Harvey71/emdr/(threads)

Thread 1 (2021-05-01):

Einschraubmuffe

LennartHennigs, 2021-05-01:
Hey Thomas,
super Projekt - ich frage mal auf Deutsch, da mich die deutschen Maße interessieren: Was für eine Muffengröße hast du für das 3/8" Gewinde genommen? Ich muss ja grade im Baumarkt vorbestellen und es leider nicht vor Ort ausprobieren.

Ich baue auch grade eine EMDR Leiste und habe zum Glück dein Video gefunden.

(Und über die "Massage" Eier habe ich sehr lachen müssen. Großartige Idee.)

VG
Lennart

Harvey71, 2021-05-01:
Hallo Lennart,
ich habe bei Amazon einen 1/4 auf 3/8-Zoll Adapter bestellt (https://www.amazon.de/gp/product/B087JTZ6XJ).
Eigentlich ist der dazu da, in Kameras mit 3/8-Zoll-Gewinde eingedreht zu werden, um diese dann auf ein Stativ mit 1/4-Zoll-Gewinde zu montieren. Das Außengewinde ist ca. 7,3mm (Kernloch) auf 9,0mm (Außendurchmesser) und das habe ich als selbstschneidendes Gewinde missbraucht.
Dazu habe ich mit einem 8mm-Bohrer ein Senkloch mittig in die Holzleiste gebohrt. Da der Adapter auch noch einen Kragen von 9,5mm Duchmesser und 1,5mm Dicke hat, habe ich das Loch 1,5mm tief mit einem 10mm-Holzbohrer aufgeweitet. Es bedarf etwas Kraft, Gedult und einen passenden Schlitzschraubendreher, um den Adapter dann in dieses Senkloch einzudrehen. Dafür sitzt das dann aber auch fest und bietet ein sauberes 1/4-Zoll Innengewinde für das Stativ.
Am besten siehst du, wie ich das Gemacht habe im Video (https://www.youtube.com/watch?v=0NRr-7e_mLk) von 0:30 bis 1:15 min.
VG
Thomas

LennartHennigs, 2021-05-01:
Ah, super. Danke für die schnelle Antwort, das hilft mir weiter. Den Adapter habe ich auch. Dann werde ich noch mal in Ruhe Dein Video schauen.
Vielen Dank.

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

Closed 2021-06-24.

Thread 2 (2022-03-11):

Wiring of lightbar.

KaboomFox, 2022-03-11:
I followed https://github.com/PaulStoffregen/WS2812Serial and connected pin 17 to 24 on the teensy board and have the data pin of the LED Strip to going to 17 VIN teensy pin but I was looking at your video in the comments you said you hooked up the data out of the led strip to the DAC pin of teensy. What is the correct Wiring of the Lightbar to Teensy?

Harvey71, 2022-03-12:
Sorry, the comment in the video is incorrect. Connecting pin 24 and 17 is correct. But then you have to use the pin/connector "17 at Vin voltage" and connect it with Din on the light strip. "17 at Vin voltage" is exactly opposite to pin 26 and oddly has not a number on its own. I guess I mixed it up when ansering the comment in the video. I will clarify this in the video's comment as well as here. Thank you for the input.

Closed 2022-03-12.

Thread 3 (2022-06-29):

Issue with Lightbar connecting to Controller

Nigel214, 2022-06-29:
Howdy,

I've created the lightbar and have tested that it works by running some of the WS2812 examples in Arduino Sketch.

First question has to do with the lightbar.ino code.  Should the first line in the file do anything? I was getting an error so I remarked it out. This line:
@@ -0,0 +1, 55 @@

I've made sure the NUMLED is correct and the Port is correct (24).  I compile the lightbar software and upload to the Teensy LC and everything looks good, but when I run the controller software it is not seeing the lightbar USB.  My Teensy LC is running as Serial USB on Com8, and I am running the controller in Windows 10.  I've made sure I have the correct versions of PYUSB, PYGAME, and Thorpy.

Any help would be greatly appreciated!

Awesome project!

Harvey71, 2022-07-04:
Please ignore the @@ line - I do not know where it comes from and I will delete it in the next release.

Regarding USB: Have you installed libusb as well? For Windows you can download a DLL here: `https://github.com/libusb/libusb/releases/download/v1.0.26/libusb-1.0.26-binaries.7z`.

When connecting the lightbar, do you hear the Windows "connect sound" and does a "USB serial" device appear in the Windows Device Manager as "USB Serial" under "USB Devices"?

Can you run this simple python script and post the output?
```
import usb
for dev in usb.core.find(find_all=True):
    print(dev)
```

ooktown, 2023-04-17:
Greetings! I'm having a similar problem.

I have a Raspberry Pi 4B with 4GB, and I'm using a Teensy 3.2 to control the Lightbar. I have separately debugged the Teensy 3.2 to work with the LED strip (I installed some test programs to verify that I could control all 60 LEDs), and also verified that the Teensy responded properly on the serial monitor with "EMDR Lightbar" and passed the test() to light up two LEDs. (**_Side note_**: I used the level shifters you recommended, and I was able to drive all 60 LEDs simultaneously using an external power supply.)

I've also gotten the interface running and can hear the ping-pong sound when I use the audio option.

However, the lightbar is not recognized, and I can't use the visual bi-lateral stimulation. Before I try making the buzzer, I want to debug the lightbar.

Here is the output when I ran the python script in your last comment:

`DEVICE ID 1d6b:0003 on Bus 002 Address 001 =================
 bLength                :   0x12 (18 bytes)
 bDescriptorType        :    0x1 Device
 bcdUSB                 :  0x300 USB 3.0
 bDeviceClass           :    0x9 Hub
 bDeviceSubClass        :    0x0
 bDeviceProtocol        :    0x3
 bMaxPacketSize0        :    0x9 (9 bytes)
 idVendor               : 0x1d6b
 idProduct              : 0x0003
 bcdDevice              :  0x601 Device 6.01
 iManufacturer          :    0x3 Error Accessing String
 iProduct               :    0x2 Error Accessing String
 iSerialNumber          :    0x1 Error Accessing String
 bNumConfigurations     :    0x1
  CONFIGURATION 1: 0 mA ====================================
   bLength              :    0x9 (9 bytes)
   bDescriptorType      :    0x2 Configuration
   wTotalLength         :   0x1f (31 bytes)
   bNumInterfaces       :    0x1
   bConfigurationValue  :    0x1
   iConfiguration       :    0x0
   bmAttributes         :   0xe0 Self Powered, Remote Wakeup
   bMaxPower            :    0x0 (0 mA)
    INTERFACE 0: Hub =======================================
     bLength            :    0x9 (9 bytes)
     bDescriptorType    :    0x4 Interface
     bInterfaceNumber   :    0x0
     bAlternateSetting  :    0x0
     bNumEndpoints      :    0x1
     bInterfaceClass    :    0x9 Hub
     bInterfaceSubClass :    0x0
     bInterfaceProtocol :    0x0
     iInterface         :    0x0
      ENDPOINT 0x81: Interrupt IN ==========================
       bLength          :    0x7 (7 bytes)
       bDescriptorType  :    0x5 Endpoint
       bEndpointAddress :   0x81 IN
       bmAttributes     :    0x3 Interrupt
       wMaxPacketSize   :    0x4 (4 bytes)
       bInterval        :    0xc
DEVICE ID 16c0:0483 on Bus 001 Address 003 =================
 bLength                :   0x12 (18 bytes)
 bDescriptorType        :    0x1 Device
 bcdUSB                 :  0x110 USB 1.1
 bDeviceClass           :    0x2 Communications Device
 bDeviceSubClass        :    0x0
 bDeviceProtocol        :    0x0
 bMaxPacketSize0        :   0x40 (64 bytes)
 idVendor               : 0x16c0
 idProduct              : 0x0483
 bcdDevice              :  0x275 Device 2.75
 iManufacturer          :    0x1 Error Accessing String
 iProduct               :    0x2 Error Accessing String
 iSerialNumber          :    0x3 Error Accessing String
 bNumConfigurations     :    0x1
  CONFIGURATION 1: 100 mA ==================================
   bLength              :    0x9 (9 bytes)
   bDescriptorType      :    0x2 Configuration
   wTotalLength         :   0x43 (67 bytes)
   bNumInterfaces       :    0x2
   bConfigurationValue  :    0x1
   iConfiguration       :    0x0
   bmAttributes         :   0xc0 Self Powered
   bMaxPower            :   0x32 (100 mA)
    INTERFACE 0: CDC Communication =========================
     bLength            :    0x9 (9 bytes)
     bDescriptorType    :    0x4 Interface
     bInterfaceNumber   :    0x0
     bAlternateSetting  :    0x0
     bNumEndpoints      :    0x1
     bInterfaceClass    :    0x2 CDC Communication
     bInterfaceSubClass :    0x2
     bInterfaceProtocol :    0x1
     iInterface         :    0x0
      ENDPOINT 0x82: Interrupt IN ==========================
       bLength          :    0x7 (7 bytes)
       bDescriptorType  :    0x5 Endpoint
       bEndpointAddress :   0x82 IN
       bmAttributes     :    0x3 Interrupt
       wMaxPacketSize   :   0x10 (16 bytes)
       bInterval        :   0x40
    INTERFACE 1: CDC Data ==================================
     bLength            :    0x9 (9 bytes)
     bDescriptorType    :    0x4 Interface
     bInterfaceNumber   :    0x1
     bAlternateSetting  :    0x0
     bNumEndpoints      :    0x2
     bInterfaceClass    :    0xa CDC Data
     bInterfaceSubClass :    0x0
     bInterfaceProtocol :    0x0
     iInterface         :    0x0
      ENDPOINT 0x3: Bulk OUT ===============================
       bLength          :    0x7 (7 bytes)
       bDescriptorType  :    0x5 Endpoint
       bEndpointAddress :    0x3 OUT
       bmAttributes     :    0x2 Bulk
       wMaxPacketSize   :   0x40 (64 bytes)
       bInterval        :    0x0
      ENDPOINT 0x84: Bulk IN ===============================
       bLength          :    0x7 (7 bytes)
       bDescriptorType  :    0x5 Endpoint
       bEndpointAddress :   0x84 IN
       bmAttributes     :    0x2 Bulk
       wMaxPacketSize   :   0x40 (64 bytes)
       bInterval        :    0x0
DEVICE ID 2109:3431 on Bus 001 Address 002 =================
 bLength                :   0x12 (18 bytes)
 bDescriptorType        :    0x1 Device
 bcdUSB                 :  0x210 USB 2.1
 bDeviceClass           :    0x9 Hub
 bDeviceSubClass        :    0x0
 bDeviceProtocol        :    0x1
 bMaxPacketSize0        :   0x40 (64 bytes)
 idVendor               : 0x2109
 idProduct              : 0x3431
 bcdDevice              :  0x421 Device 4.21
 iManufacturer          :    0x0
 iProduct               :    0x1 Error Accessing String
 iSerialNumber          :    0x0
 bNumConfigurations     :    0x1
  CONFIGURATION 1: 100 mA ==================================
   bLength              :    0x9 (9 bytes)
   bDescriptorType      :    0x2 Configuration
   wTotalLength         :   0x19 (25 bytes)
   bNumInterfaces       :    0x1
   bConfigurationValue  :    0x1
   iConfiguration       :    0x0
   bmAttributes         :   0xe0 Self Powered, Remote Wakeup
   bMaxPower            :   0x32 (100 mA)
    INTERFACE 0: Hub =======================================
     bLength            :    0x9 (9 bytes)
     bDescriptorType    :    0x4 Interface
     bInterfaceNumber   :    0x0
     bAlternateSetting  :    0x0
     bNumEndpoints      :    0x1
     bInterfaceClass    :    0x9 Hub
     bInterfaceSubClass :    0x0
     bInterfaceProtocol :    0x0
     iInterface         :    0x0
      ENDPOINT 0x81: Interrupt IN ==========================
       bLength          :    0x7 (7 bytes)
       bDescriptorType  :    0x5 Endpoint
       bEndpointAddress :   0x81 IN
       bmAttributes     :    0x3 Interrupt
       wMaxPacketSize   :    0x1 (1 bytes)
       bInterval        :    0xc
DEVICE ID 1d6b:0002 on Bus 001 Address 001 =================
 bLength                :   0x12 (18 bytes)
 bDescriptorType        :    0x1 Device
 bcdUSB                 :  0x200 USB 2.0
 bDeviceClass           :    0x9 Hub
 bDeviceSubClass        :    0x0
 bDeviceProtocol        :    0x1
 bMaxPacketSize0        :   0x40 (64 bytes)
 idVendor               : 0x1d6b
 idProduct              : 0x0002
 bcdDevice              :  0x601 Device 6.01
 iManufacturer          :    0x3 Error Accessing String
 iProduct               :    0x2 Error Accessing String
 iSerialNumber          :    0x1 Error Accessing String
 bNumConfigurations     :    0x1
  CONFIGURATION 1: 0 mA ====================================
   bLength              :    0x9 (9 bytes)
   bDescriptorType      :    0x2 Configuration
   wTotalLength         :   0x19 (25 bytes)
   bNumInterfaces       :    0x1
   bConfigurationValue  :    0x1
   iConfiguration       :    0x0
   bmAttributes         :   0xe0 Self Powered, Remote Wakeup
   bMaxPower            :    0x0 (0 mA)
    INTERFACE 0: Hub =======================================
     bLength            :    0x9 (9 bytes)
     bDescriptorType    :    0x4 Interface
     bInterfaceNumber   :    0x0
     bAlternateSetting  :    0x0
     bNumEndpoints      :    0x1
     bInterfaceClass    :    0x9 Hub
     bInterfaceSubClass :    0x0
     bInterfaceProtocol :    0x0
     iInterface         :    0x0
      ENDPOINT 0x81: Interrupt IN ==========================
       bLength          :    0x7 (7 bytes)
       bDescriptorType  :    0x5 Endpoint
       bEndpointAddress :   0x81 IN
       bmAttributes     :    0x3 Interrupt
       wMaxPacketSize   :    0x4 (4 bytes)
       bInterval        :    0xc
`

Sorry for all that output! I wasn't sure what was relevant.

I'm thinking I might need to update the VendorID and/or the device hex code. Any help would be appreciated! I think I am REALLY CLOSE to getting this to work! I would appreciate any help you can send my way.

Harvey71, 2023-04-17:
Hey, ooktown.

Vendor Id (0x16c0) looks good to me. I have some questions for you:
- When connecting the light bar, do you see the test blink (left LED red and right LED green for half a second)? If yes, you can stop here and come back to me. If no, please continue reading.
- To what pin on the Teensy did you connect the WS2812 data line (or the level shifter input)? Please note: On Teensy 3.2 you can only use pins 1, 5, 10, 31 or 8.
- Did you change line 12 in lightbar.ino accordingly? The fourth parameter of WS2812Serial init must match the used pin. So, if you want to use pin 8, you would have to change it to: `WS2812Serial leds(60, displayMemory, drawingMemory, 8, WS2812_GRB);`. Background if you do not change that line, the WS2812Serial library will crash on Teensy3.2, because it cannot handle pin 24, which is default for TeensyLC!
- If you open the serial monitor at Teensyduiono and enter "i" in the input line and press SEND (or the RETURN key), does the string "EMDR Lightbar" appear in the response area?

ooktown, 2023-04-17:
Greetings! Thanks for the quick response. To answer your question(s):

- Yes, I see the test blink (left LED red and right LED green for half a second).
- I also confirmed via the Serial Monitor in VSCode that when I type in 'i', the Teensy responds back with 'EMDR Lightbar'.

Harvey71, 2023-04-17:
Okay, so the lightbar seems to work properly. Then it must be an issue with the controller. Could you please run this simple Python script an give me the outputs?
```
import usb
devs = usb.core.find(find_all=True, idVendor=0x16c0)
dev=next(devs)
print(dev)
dev.write(0x03, 'i\n')
id_arr = dev.read(0x84, size_or_buffer=64, timeout=100)
id_str = ''.join(chr(x) for x in id_arr).strip()
print(id_str)
dev.finalize()
```

If this works fine and prints out "EMDR Lightbar", then please delete line 50-52 from devices.py and try the controller again.

ooktown, 2023-04-17:
Ok! It looks like there are errors when I run they Python script. Here are the results:

```
pi@emdr-controller:~ $ sudo python3
Python 3.9.2 (default, Mar 12 2021, 04:06:34)
[GCC 10.2.1 20210110] on linux
Type "help", "copyright", "credits" or "license" for more information.
>>> import usb
>>> devs = usb.core.find(find_all=True, idVendor=0x16c0)
>>> dev=next(devs)
>>> print(dev)
DEVICE ID 16c0:0483 on Bus 001 Address 003 =================
 bLength                :   0x12 (18 bytes)
 bDescriptorType        :    0x1 Device
 bcdUSB                 :  0x110 USB 1.1
 bDeviceClass           :    0x2 Communications Device
 bDeviceSubClass        :    0x0
 bDeviceProtocol        :    0x0
 bMaxPacketSize0        :   0x40 (64 bytes)
 idVendor               : 0x16c0
 idProduct              : 0x0483
 bcdDevice              :  0x275 Device 2.75
 iManufacturer          :    0x1 Teensyduino
 iProduct               :    0x2 USB Serial
 iSerialNumber          :    0x3 5713550
 bNumConfigurations     :    0x1
  CONFIGURATION 1: 100 mA ==================================
   bLength              :    0x9 (9 bytes)
   bDescriptorType      :    0x2 Configuration
   wTotalLength         :   0x43 (67 bytes)
   bNumInterfaces       :    0x2
   bConfigurationValue  :    0x1
   iConfiguration       :    0x0
   bmAttributes         :   0xc0 Self Powered
   bMaxPower            :   0x32 (100 mA)
    INTERFACE 0: CDC Communication =========================
     bLength            :    0x9 (9 bytes)
     bDescriptorType    :    0x4 Interface
     bInterfaceNumber   :    0x0
     bAlternateSetting  :    0x0
     bNumEndpoints      :    0x1
     bInterfaceClass    :    0x2 CDC Communication
     bInterfaceSubClass :    0x2
     bInterfaceProtocol :    0x1
     iInterface         :    0x0
      ENDPOINT 0x82: Interrupt IN ==========================
       bLength          :    0x7 (7 bytes)
       bDescriptorType  :    0x5 Endpoint
       bEndpointAddress :   0x82 IN
       bmAttributes     :    0x3 Interrupt
       wMaxPacketSize   :   0x10 (16 bytes)
       bInterval        :   0x40
    INTERFACE 1: CDC Data ==================================
     bLength            :    0x9 (9 bytes)
     bDescriptorType    :    0x4 Interface
     bInterfaceNumber   :    0x1
     bAlternateSetting  :    0x0
     bNumEndpoints      :    0x2
     bInterfaceClass    :    0xa CDC Data
     bInterfaceSubClass :    0x0
     bInterfaceProtocol :    0x0
     iInterface         :    0x0
      ENDPOINT 0x3: Bulk OUT ===============================
       bLength          :    0x7 (7 bytes)
       bDescriptorType  :    0x5 Endpoint
       bEndpointAddress :    0x3 OUT
       bmAttributes     :    0x2 Bulk
       wMaxPacketSize   :   0x40 (64 bytes)
       bInterval        :    0x0
      ENDPOINT 0x84: Bulk IN ===============================
       bLength          :    0x7 (7 bytes)
       bDescriptorType  :    0x5 Endpoint
       bEndpointAddress :   0x84 IN
       bmAttributes     :    0x2 Bulk
       wMaxPacketSize   :   0x40 (64 bytes)
       bInterval        :    0x0
>>> dev.write(0x03, 'i\n')
Traceback (most recent call last):
  File "/usr/local/lib/python3.9/dist-packages/usb/_interop.py", line 92, in as_array
    return array.array('B', data)
TypeError: cannot use a str to initialize an array with typecode 'B'

During handling of the above exception, another exception occurred:

Traceback (most recent call last):
  File "<stdin>", line 1, in <module>
  File "/usr/local/lib/python3.9/dist-packages/usb/core.py", line 947, in write
    _interop.as_array(data),
  File "/usr/local/lib/python3.9/dist-packages/usb/_interop.py", line 97, in as_array
    a.fromstring(data) # deprecated since 3.2
AttributeError: 'array.array' object has no attribute 'fromstring'
>>> id_arr = dev.read(0x84, size_or_buffer=64, timeout=100)
Traceback (most recent call last):
  File "<stdin>", line 1, in <module>
  File "/usr/local/lib/python3.9/dist-packages/usb/core.py", line 983, in read
    ret = fn(
  File "/usr/local/lib/python3.9/dist-packages/usb/backend/libusb1.py", line 828, in bulk_read
    return self.__read(self.lib.libusb_bulk_transfer,
  File "/usr/local/lib/python3.9/dist-packages/usb/backend/libusb1.py", line 936, in __read
    _check(retval)
  File "/usr/local/lib/python3.9/dist-packages/usb/backend/libusb1.py", line 595, in _check
    raise USBError(_strerror(ret), ret, _libusb_errno[ret])
usb.core.USBError: [Errno 110] Operation timed out
>>> id_str = ''.join(chr(x) for x in id_arr).strip()
Traceback (most recent call last):
  File "<stdin>", line 1, in <module>
NameError: name 'id_arr' is not defined
>>> print(id_str)
Traceback (most recent call last):
  File "<stdin>", line 1, in <module>
NameError: name 'id_str' is not defined
>>> dev.finalize()
>>>
>>>
```

Harvey71, 2023-04-18:
After some research: unfortunately, pyUSB 1.0.2 is incompatible with Python 3.9. Please either degrade Python to 3.8 or update pyUSB to latest version. You can do the latter by: ``pip install --upgrade pyusb``. Also it would be a good idea to exchange the first line of the requirements.txt file with ``pyusb==1.2.1``. If you give me positive feedback, I will commit this change to the repo, so that further users will not have the same troubles...

ooktown, 2023-04-18:
Thank you SO MUCH for your help and diligent research! I will try this out later today or tomorrow and comment back either way on the results.

ooktown, 2023-04-19:
Here's my update:

- Updated pyUSB to 1.2.1. **Controller was not able to identify Lightbar.**
- Attempted to use Pyenv to roll back the Python version. **Could not get sudo to work with Pyenv.**
- Installed Python 3.8.16 and explicitly added the path in the autostart file. **This hung the system on boot up.**

Based on the results, and the difficulty of managing multiple versions of Python ond PyUSB, my next step will be to:

- perform a clean, minimal install of Linux on the Raspberry Pi 4.
- Install Python 3.8 and dependent versions of apps and utilities via pip3 and requirements.txt.
- Test the clean install with the Lightbar.

Let me know what you think of my plan.

ooktown, 2023-04-20:
I could not get Python 3.8 to run with the required modules (pyUSB, pygame, thorpy, pysdl2-dll) because the default dependency was to have Python 3.9 installed.

I attempted to work around this by downloading and installing pygame and thorpy, for example, but I wasn't able to get them to load in the Python script when running Python 3.8.

So, now I'm going to go back trying to learn Python and re-factor the code to use the latest version of pyUSB, pygame, thorpy, etc. Lots to learn!

Harvey71, 2023-04-20:
I strongly recommend that you stick with your 3.9 Python version and upgrade pyUSB. In the meantime, I have bumped my Python version to 3.9.16 on MacOS and the lightbar is reliably detected. I have committed some changes to the controller source - maybe that will help. If you still have this problem, could you please run the script I gave you 3 days ago again? If you have updated pyUSB you should get a different error now.

ooktown, 2023-04-20:
I got the Lightbar working! AWESOME. Thank you so much for your help and updating the code/configuration files!

I had to slightly modify the PiBakery recipe, and I also ran these command manually. Here's the recipe I ended up using to make the Lightbar work on a Raspberry Pi 4 4GB:

- Used Raspberry Pi Imager v1.7.4 to load Pi OS 32-bit desktop Bullseye onto the microSD card
- Booted the Pi using the microSD card and went through the basic configuration of the Pi using a keyboard plugged into the Pi
- Enabled SSH so I could remote in and run commands from my Mac

After the initial set up, I SSH'ed into the Pi:
- Ran commands as user pi (no change from your recipe):

`until (curl https://github.com -o /dev/null); do sleep 1; done`

- Installed packages:

```
sudo apt-get install libusb-1.0-0-dev
sudo apt install python3-sdl2
```

- Run commands as  pi and root:

```
git clone https://github.com/Harvey71/emdr
cp emdr/controller/* ~ -r
sudo pip3 install -r requirements.txt
mkdir -p ~/.config/lxsession/LXDE-pi
echo sudo python3 main.py fullscreen touchscreen>~/.config/lxsession/LXDE-pi/autostart
sudo chmod 755 *.py
```

- Ran commands as root for 3.5” display:

```
sudo rm -rf LCD-show
git clone https://github.com/goodtft/LCD-show.git
chmod -R 755 LCD-show
cd LCD-show&&sudo ./LCD35-show 180
```

And when the Pi rebooted, the Lightbar was recognized, and I could start the LED sequence.

Closed 2023-04-21.

Thread 4 (2023-01-23):

Pibakery not available

dmbe11, 2023-01-23:
Do you know of another way to build the image for the lightbar controller without the pibakery. It seems to be gone and the old versions wont work

thx

Harvey71, 2023-01-23:
You can still install the Pi the classic way:

1. Flash a recent Rasbian image (desktop version) and boot the Pi
2. Connect Pi to you local LAN
3. Log in with SSH
4. Install libraries:
```
sudo apt-get update
sudo apt-get install libusb-1.0.0-dev
sudo apt-get install python3-sdl
```
5. Clone repo and install python packages:
```
git clone https://github.com/Harvey71/emdr
cp emdr/controller/* ~ -r
sudo pip3 install -r requirements.txt
```
6. Configure auto-start
```
mkdir -p ~/.config/lxsession/LXDE-pi
echo sudo python3 main.py fullscreen touchscreen >~/.config/lxsession/LXDE-pi/autostart
```
7. Install and config LCD driver
```
git clone https://github.com/goodtft/LCD-show.git
chmod -R 755 LCD-show
cd LCD-show
./MHS35-show 180
```
8. Configure audio
```
echo "dtparam=audio=on"|cat - boot/config.txt &>/boot/config.tmp
mv /boot/config.tmp /boot/config.txt
```
9. Reboot
10. Now, the LCD should show the controller GUI

Unfortunately, I do not have a spare Raspberry Pi at hand, so I cannot test the above instructions. Maybe you have to adjust a thing or two, depending on Rapsbian version.

Good luck!

dmbe11, 2023-01-24:
Thanks, I thought that would be the next option. Thank you for verifying. The ability to give people suffering from trauma is really dramatic with these types of devices.
Thanks for putting this out here.

dmbe11, 2023-01-24:
I was able to install everything except for the Python3-sdl but I was able to install the sdl2 version that I found as a solution. I ran the print (dev) script you posted and received this:
DEVICE ID 1d6b:0003 on Bus 002 Address 001 =================
 bLength                :   0x12 (18 bytes)
 bDescriptorType        :    0x1 Device
 bcdUSB                 :  0x300 USB 3.0
 bDeviceClass           :    0x9 Hub
 bDeviceSubClass        :    0x0
 bDeviceProtocol        :    0x3
 bMaxPacketSize0        :    0x9 (9 bytes)
 idVendor               : 0x1d6b
 idProduct              : 0x0003
 bcdDevice              :  0x515 Device 5.15
 iManufacturer          :    0x3 Error Accessing String
 iProduct               :    0x2 Error Accessing String
 iSerialNumber          :    0x1 Error Accessing String
 bNumConfigurations     :    0x1
  CONFIGURATION 1: 0 mA ====================================
   bLength              :    0x9 (9 bytes)
   bDescriptorType      :    0x2 Configuration
   wTotalLength         :   0x1f (31 bytes)
   bNumInterfaces       :    0x1
   bConfigurationValue  :    0x1
   iConfiguration       :    0x0
   bmAttributes         :   0xe0 Self Powered, Remote Wakeup
   bMaxPower            :    0x0 (0 mA)
    INTERFACE 0: Hub =======================================
     bLength            :    0x9 (9 bytes)
     bDescriptorType    :    0x4 Interface
     bInterfaceNumber   :    0x0
     bAlternateSetting  :    0x0
     bNumEndpoints      :    0x1
     bInterfaceClass    :    0x9 Hub
     bInterfaceSubClass :    0x0
     bInterfaceProtocol :    0x0
     iInterface         :    0x0
      ENDPOINT 0x81: Interrupt IN ==========================
       bLength          :    0x7 (7 bytes)
       bDescriptorType  :    0x5 Endpoint
       bEndpointAddress :   0x81 IN
       bmAttributes     :    0x3 Interrupt
       wMaxPacketSize   :    0x4 (4 bytes)
       bInterval        :    0xc
DEVICE ID 045e:0800 on Bus 001 Address 003 =================
 bLength                :   0x12 (18 bytes)
 bDescriptorType        :    0x1 Device
 bcdUSB                 :  0x200 USB 2.0
 bDeviceClass           :    0x0 Specified at interface
 bDeviceSubClass        :    0x0
 bDeviceProtocol        :    0x0
 bMaxPacketSize0        :   0x40 (64 bytes)
 idVendor               : 0x045e
 idProduct              : 0x0800
 bcdDevice              :  0x934 Device 9.34
 iManufacturer          :    0x1 Error Accessing String
 iProduct               :    0x2 Error Accessing String
 iSerialNumber          :    0x0
 bNumConfigurations     :    0x1
  CONFIGURATION 1: 100 mA ==================================
   bLength              :    0x9 (9 bytes)
   bDescriptorType      :    0x2 Configuration
   wTotalLength         :   0x54 (84 bytes)
   bNumInterfaces       :    0x3
   bConfigurationValue  :    0x1
   iConfiguration       :    0x0
   bmAttributes         :   0xa0 Bus Powered, Remote Wakeup
   bMaxPower            :   0x32 (100 mA)
    INTERFACE 0: Human Interface Device ====================
     bLength            :    0x9 (9 bytes)
     bDescriptorType    :    0x4 Interface
     bInterfaceNumber   :    0x0
     bAlternateSetting  :    0x0
     bNumEndpoints      :    0x1
     bInterfaceClass    :    0x3 Human Interface Device
     bInterfaceSubClass :    0x1
     bInterfaceProtocol :    0x1
     iInterface         :    0x0
      ENDPOINT 0x81: Interrupt IN ==========================
       bLength          :    0x7 (7 bytes)
       bDescriptorType  :    0x5 Endpoint
       bEndpointAddress :   0x81 IN
       bmAttributes     :    0x3 Interrupt
       wMaxPacketSize   :    0x8 (8 bytes)
       bInterval        :    0x4
    INTERFACE 1: Human Interface Device ====================
     bLength            :    0x9 (9 bytes)
     bDescriptorType    :    0x4 Interface
     bInterfaceNumber   :    0x1
     bAlternateSetting  :    0x0
     bNumEndpoints      :    0x1
     bInterfaceClass    :    0x3 Human Interface Device
     bInterfaceSubClass :    0x1
     bInterfaceProtocol :    0x2
     iInterface         :    0x0
      ENDPOINT 0x82: Interrupt IN ==========================
       bLength          :    0x7 (7 bytes)
       bDescriptorType  :    0x5 Endpoint
       bEndpointAddress :   0x82 IN
       bmAttributes     :    0x3 Interrupt
       wMaxPacketSize   :    0xa (10 bytes)
       bInterval        :    0x1
    INTERFACE 2: Human Interface Device ====================
     bLength            :    0x9 (9 bytes)
     bDescriptorType    :    0x4 Interface
     bInterfaceNumber   :    0x2
     bAlternateSetting  :    0x0
     bNumEndpoints      :    0x1
     bInterfaceClass    :    0x3 Human Interface Device
     bInterfaceSubClass :    0x0
     bInterfaceProtocol :    0x0
     iInterface         :    0x0
      ENDPOINT 0x83: Interrupt IN ==========================
       bLength          :    0x7 (7 bytes)
       bDescriptorType  :    0x5 Endpoint
       bEndpointAddress :   0x83 IN
       bmAttributes     :    0x3 Interrupt
       wMaxPacketSize   :   0x20 (32 bytes)
       bInterval        :    0x1
DEVICE ID 2109:3431 on Bus 001 Address 002 =================
 bLength                :   0x12 (18 bytes)
 bDescriptorType        :    0x1 Device
 bcdUSB                 :  0x210 USB 2.1
 bDeviceClass           :    0x9 Hub
 bDeviceSubClass        :    0x0
 bDeviceProtocol        :    0x1
 bMaxPacketSize0        :   0x40 (64 bytes)
 idVendor               : 0x2109
 idProduct              : 0x3431
 bcdDevice              :  0x421 Device 4.21
 iManufacturer          :    0x0
 iProduct               :    0x1 Error Accessing String
 iSerialNumber          :    0x0
 bNumConfigurations     :    0x1
  CONFIGURATION 1: 100 mA ==================================
   bLength              :    0x9 (9 bytes)
   bDescriptorType      :    0x2 Configuration
   wTotalLength         :   0x19 (25 bytes)
   bNumInterfaces       :    0x1
   bConfigurationValue  :    0x1
   iConfiguration       :    0x0
   bmAttributes         :   0xe0 Self Powered, Remote Wakeup
   bMaxPower            :   0x32 (100 mA)
    INTERFACE 0: Hub =======================================
     bLength            :    0x9 (9 bytes)
     bDescriptorType    :    0x4 Interface
     bInterfaceNumber   :    0x0
     bAlternateSetting  :    0x0
     bNumEndpoints      :    0x1
     bInterfaceClass    :    0x9 Hub
     bInterfaceSubClass :    0x0
     bInterfaceProtocol :    0x0
     iInterface         :    0x0
      ENDPOINT 0x81: Interrupt IN ==========================
       bLength          :    0x7 (7 bytes)
       bDescriptorType  :    0x5 Endpoint
       bEndpointAddress :   0x81 IN
       bmAttributes     :    0x3 Interrupt
       wMaxPacketSize   :    0x1 (1 bytes)
       bInterval        :    0xc
DEVICE ID 1d6b:0002 on Bus 001 Address 001 =================
 bLength                :   0x12 (18 bytes)
 bDescriptorType        :    0x1 Device
 bcdUSB                 :  0x200 USB 2.0
 bDeviceClass           :    0x9 Hub
 bDeviceSubClass        :    0x0
 bDeviceProtocol        :    0x1
 bMaxPacketSize0        :   0x40 (64 bytes)
 idVendor               : 0x1d6b
 idProduct              : 0x0002
 bcdDevice              :  0x515 Device 5.15
 iManufacturer          :    0x3 Error Accessing String
 iProduct               :    0x2 Error Accessing String
 iSerialNumber          :    0x1 Error Accessing String
 bNumConfigurations     :    0x1
  CONFIGURATION 1: 0 mA ====================================
   bLength              :    0x9 (9 bytes)
   bDescriptorType      :    0x2 Configuration
   wTotalLength         :   0x19 (25 bytes)
   bNumInterfaces       :    0x1
   bConfigurationValue  :    0x1
   iConfiguration       :    0x0
   bmAttributes         :   0xe0 Self Powered, Remote Wakeup
   bMaxPower            :    0x0 (0 mA)
    INTERFACE 0: Hub =======================================
     bLength            :    0x9 (9 bytes)
     bDescriptorType    :    0x4 Interface
     bInterfaceNumber   :    0x0
     bAlternateSetting  :    0x0
     bNumEndpoints      :    0x1
     bInterfaceClass    :    0x9 Hub
     bInterfaceSubClass :    0x0
     bInterfaceProtocol :    0x0
     iInterface         :    0x0
      ENDPOINT 0x81: Interrupt IN ==========================
       bLength          :    0x7 (7 bytes)
       bDescriptorType  :    0x5 Endpoint
       bEndpointAddress :   0x81 IN
       bmAttributes     :    0x3 Interrupt
       wMaxPacketSize   :    0x4 (4 bytes)
       bInterval        :    0xc
>>>
Im not sure what I am looking. Here is some additional info that might help:

the GUI loads but is is pretty small. When I get the buttons to work I can once in a while get a single led to work. If I run one of the sketches from the  WS2812 Serial library and they work fine. The Only other thing I can think of is that I have the 2812b lights. Anything come to mind. The behavior is really close to what I got when running the controller via my mac or another machine I tested on that is a linux mint PC.  I'm kind of stuck since I don't really understand the program I think because it is not really operated from the sketch on the teensy but somewhere in the python files.  thx again

dmbe11, 2023-01-24:
Thomas,
I had ordered the correct size screen and it came in today.  I installed and it loads in the pi just fine. It still does not control the led strip and I am not sure why. Any ideas? Could it be the strip is the B version of the 2812’s: 2812B?

From: Thomas Niebur ***@***.***>
Reply-To: Harvey71/emdr ***@***.***>
Date: Monday, January 23, 2023 at 4:06 PM
To: Harvey71/emdr ***@***.***>
Cc: Daniel Bell ***@***.***>, Author ***@***.***>
Subject: Re: [Harvey71/emdr] Pibakery not available (Issue #4)

CAUTION: This email originated from outside of the organization. Do not click links or open attachments unless you recognize the sender and know the content is safe.

You can still install the Pi the classic way:

  1.  Flash a recent Rasbian image (desktop version) and boot the Pi
  2.  Connect Pi to you local LAN
  3.  Log in with SSH
  4.  Install libraries:

sudo apt-get update

sudo apt-get install libusb-1.0.0-dev

sudo apt-get install python3-sdl

  1.  Clone repo and install python packages:

git clone https://url.avanan.click/v2/___https://github.com/Harvey71/emdr___.YXAzOmZyYW5rbGluZWR1OmE6bzo1Y2E0Mjk4ZTI1ZDIzZGE0NTQ5MTQ4NzM5YmI1ZmMwODo2OjU3NWI6MTJhZDg3MTE4Y2RlZm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

cp emdr/controller/* ~ -r

sudo pip3 install -r requirements.txt

  1.  Configure auto-start

mkdir -p ~/.config/lxsession/LXDE-pi

echo sudo python3 main.py fullscreen touchscreen >~/.config/lxsession/LXDE-pi/autostart

  1.  Install and config LCD driver

git clone https://url.avanan.click/v2/___https://github.com/goodtft/LCD-show.git___.YXAzOmZyYW5rbGluZWR1OmE6bzo1Y2E0Mjk4ZTI1ZDIzZGE0NTQ5MTQ4NzM5YmI1ZmMwODo2OmIzODk6NjExMWJjOTc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

chmod -R 755 LCD-show

cd LCD-show

./MHS35-show 180

  1.  Configure audio

echo "dtparam=audio=on"|cat - boot/config.txt &>/boot/config.tmp

mv /boot/config.tmp /boot/config.txt

  1.  Reboot
  2.  Now, the LCD should show the controller GUI

Unfortunately, I do not have a spare Raspberry Pi at hand, so I cannot test the above instructions. Maybe you have to adjust a thing or two, depending on Rapsbian version.

Good luck!

—
Reply to this email directly, view it on GitHub<https://url.avanan.click/v2/___https:/github.com/Harvey71/emdr/issues/4%23issuecomment-1400977241___.YXAzOmZyYW5rbGluZWR1OmE6bzo1Y2E0Mjk4ZTI1ZDIzZGE0NTQ5MTQ4NzM5YmI1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>, or unsubscribe<https://url.avanan.click/v2/___https:/github.com/notifications/unsubscribe-auth/ABPDAEEFXQ22CNHGFHNWNDLWT3XCNANCNFSM6AAAAAAUDPC6HI___.YXAzOmZyYW5rbGluZWR1OmE6bzo1Y2E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>.
You are rece iving this because you authored the thread.Message ID: ***@***.***>

Closed 2023-01-25.

Thread 5 (2023-01-27):

Tinsy lc

MrLately, 2023-01-27:
Hello Harvey, thank you for this great tool. I'm having trouble finding timsy lc. What are some compatible devices if some of these aren't available?

Harvey71, 2023-01-27:
Hi Mr Lately, I just took a look and I am shocked by the prices you have to pay for a Teensy LC nowadays - if you can get one at all. Sadly, I don't think that there is a drop-in replacement, but actually you can use any microcontroller with an active USB port. If I would do this project now, I would choose a RP2040 based µC, like the Raspberry Pico. I chose the Teensy LC, because it has a 5V driver on board. But it seems that actual WS2812B (with the B) LED stips work fine with 3.3V output of a Pico - but no guarantees. Please refer to this link: https://www.freva.com/how-to-control-a-neopixel-led-strip-with-a-raspberry-pi-pico/ I am pretty sure, you have to adjust the source code for the lightbar firmware. I am sorry, but I currently don't have the time (and equipment) to do that, so that would be up to you. Maybe I will find the time later this year. I will order a LED strip right away.

MrLately, 2023-01-27:
I just bought the ws2812b / 60 led / 1 meter strip. I've written a tkinter script with a canvas already then I found your project. Was thinking about using a pico or just run it from a 3b with the rpi_281x library to minimize hardware. I will put what I have on my GitHub later if you want to take a look in your free time. Thank you for your response and time.

MrLately, 2023-01-31:
https://github.com/MrLately/blink-and-slide/tree/main

Closed 2023-04-21.

Thread 6 (2023-02-01):

Updating problems getting light bar to work.

dmbe11, 2023-02-01:
Thomas,
I was out of town for a bit and didn't have a chance to reply. My issue is not with the controller; it is working. The issue is either with the sketch or the communication between the controller and the Teensy.

Here are some clues that I observed:
1. The sound works from the controller, but I can only get a single led to the light.
2. I get the same responses if I run the controller from a Mac, Mint Linux, or the pie.
3. When I say the controller is working, I mean the play, pause, and stop buttons. The eye icon and the? Done seen to have any effect.
Also, do you have the procedure you posted for loading the controller on the pi? I may need to reinstall it, and I did not save it anywhere. I hope this helps; if not perhaps you could suggest where to start looking>
thank you again

Harvey71, 2023-02-05:
When you execute this
```
import usb
for dev in usb.core.find(find_all=True):
    print(dev)
```
in your Python environment with properly flashed and attached Teensy LC, there should be something like this
```
DEVICE ID 16c0:0483 on Bus 020 Address 022 =================
 bLength                :   0x12 (18 bytes)
 bDescriptorType        :    0x1 Device
 bcdUSB                 :  0x110 USB 1.1
 bDeviceClass           :    0x2 Communications Device
 bDeviceSubClass        :    0x0
 bDeviceProtocol        :    0x0
 bMaxPacketSize0        :   0x40 (64 bytes)
 idVendor               : 0x16c0
 idProduct              : 0x0483
 bcdDevice              :  0x273 Device 2.73
 iManufacturer          :    0x1 Teensyduino
 iProduct               :    0x2 USB Serial
 iSerialNumber          :    0x3 5667580
 bNumConfigurations     :    0x1
```
printed to screen. If not, your Teensy is either not properly flashed or not properly attached to your USB. To check that, you do **not** need the controller software:

1. Check, whether Teensy is properly flashed.
When attaching the light bar to your USB port, the outer LEDS should be lit for half a second, one in red, the other in green. If you see only the green one, you have to adjust NUMLED in the firmware's source code to the number of LEDs of your stripe. If you do not see the 0.5 secs flash at all, something went wrong with programming the Teensy. Try it again.
2. Try another USB cable.
Surprisingly, not all USB cables work properly with Teensy. So best try some different vendors and lengths. I got best results with Amazon Basic Cables.

Good luck

dmbe11, 2023-02-06:
Thank you for the information. I verified that the teensy is working correctly, but unfortunately, I had to reinstall the software on my pi. I decided to install the legacy 32-bit version and would like you to provide the steps for installing the Controller Software on the PI. Here is what I recall stepwise:
1. Create a Controller Directory
2. download EMDR folders and files
3. pip3 install -r requirements.txt
4. Download and install libusb
5. Setup autostart on pi

That's about what I recall. Thanks for your help.

Dan

By the way! Harvey is a great film. I have a copy on DVD that I dug out a week ago. The lady who played the female nurse was a good actress but retired only a few years later to marry. They stayed married for 60+ years, quite uncommon for an actor today.

Harvey71, 2023-02-06:
For setting up Raspberry Pi without PiBakery, please refer to: https://github.com/Harvey71/emdr/issues/4

dmbe11, 2023-02-06:
Thank you, Thomas

Daniel Bell, PhD
Program Chair, Interactive Media Design
Franklin University
***@***.******@***.***>
614.947.6117

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

dmbe11, 2023-02-07:
Hi Thomas,
any idea why this command is returning Permission Denied?

echo "dtparam=audio=on"|cat - boot/config.txt &>/boot/config.tmp

Harvey71, 2023-02-07:
You have to be root to write to that file. Try this before:
`sudo su`

dmbe11, 2023-02-07:
would python3-sdl2 be a viable alternative for E: python3-sdl?  I get an error: E: Unable to locate package python3-sdl

Harvey71, 2023-02-07:
Should work, too. Just try it. :-)

Closed 2023-04-21.

Thread 7 (2023-03-31):

Very cool design! Some hook up questions about pin 17 driver

ooktown, 2023-03-31:
Greetings! First: THANK YOU for open-sourcing the design of this EMDR kit!

The Teensy LC's are hard to come by, so I am planning on using Teensy 4.0 with a TTL level shifter to go from 3.3V to 5V.

My question: Will that work?

Can I then hook up pin 24 of the Teensy 4.0 via the level shifter to the DI of the WS2812?

Harvey71, 2023-04-01:
Teensy 4.0 with level shifter should work fine. You can use any pin that is supported by the WS2812Serial library - this includes pin 24. You could even try without level shifter. Maybe you are lucky, but I would not recommend it. WS2812B datasheet claims 3.5V is minimum for logic high, so 3.3V is too low. If you use a level shifter, please use a fast one (e.g. TXS0108E). I read about troubles with simple bidirectional level shifters for I2C, since they skew too slow from low to high.

ooktown, 2023-04-01:
Thank you! That answers my question. Now I just need to wait for RPi4 to become reasonably priced... In the meantime I'll put together the kit over time and try it out with my Mac.

Closed 2023-04-01.

Thread 8 (2023-04-22):

RPi Zero W2 substitution?

etknorr, 2023-04-22:
Hey, thanks for this great guide! A friend asked me about making one of these setups and this is exactly the path I was going to start heading down. I have some raspberry pi's laying around which I'm not keen on giving up given the state of the Pi market... I'm curious if you had insight on if a Pi Zero W2 would be up to this task? A list of concerns arises:

Concerns:
* Processing power for the Pygame app
  * I think this would be okay for a relatively simple app that it is.
* Power consumption
  * Thinking specifically of the buzzers.. thoughts?
  * Likely would be fine, even if I had to power the Teensy through external power (not through the Pi)
* Obvious limitation of USB ports
  * Potentially use an OTG cable --> USB Hub (???)
  * Could use only one device at a time (either buzzers or light bar, not both)

Harvey71, 2023-04-22:
I share your concerns with replacing the Pi by a Pi zero, but partially for different reasons:

- The devices (Teensy) are powered by the 5V line of the USB bus, which is more or less diectly connected to the external power supply. I recommend a 5V/1A power adapter - then you should be safe.
- The Pi zero only has one USB port. If you only use either light bar or buzzers at the same time, that should not bother you. If you plan to use both at the same time, a USB Hub would work. But that would be nasty cabling on the table. I would rather spend the money for a Raspberry Pi 3/4 than for the hub.
- Processing power should not be an issue. But maybe the 512MB RAM is a bit tight. You would have to try that out.
- My major concern is the different form factor. Thus you cannot use the out-of-the box casing for the display. Worst case you have to tinker (3D-print) a casing on your own.

TL;DR: I do not recommend using the RPi Zero. If you want to have a standalone controller, go with a Raspberry Pi 3/4 or drop-in-replacement. But I want to emphasize, that if the user has a PC or Laptop in their office, they can attach the light bar and buzzers directly to it. The controller software will run on Windows or MacOS in a window. Then you would not need any Raspberry at all.

If you sill want to use the RPi Zero, I wish you good luck and look forward to your feedback about your success. :-)

Closed 2023-04-23.

Thread 9 (2023-07-03):

Audio

deestruct, 2023-07-03:
After struggling to get the setup to function from the tutorials, I was finally able to get it working using the final instructions provided by ooktown #3 which closed that issue. I am still awaiting some components to arrive so have not completed the fabricating the buzzers and lightbar hardware devices, but did get the RPi 4 and TFT 3.5" screen working now.

I am not getting audio though from the device on my headset connected to the 3.5mm jack when I test the sound via the GUI.  I can confirm that the audio is working in the RPi as when I connect to it via SSH and perform a basic audio test with the code `speaker-test -c2 -twav -l7`, I can hear the test functioning properly in my headset.  Immediately after the audio test is complete, I try the audio again using the GUI on the TFT screen and I cannot hear any sounds.

However, if I connect the RPi to my monitor using an HDMI cable and try testing the audio on the EMDR GUI I can hear the tones properly.

Can you please assist me in resolving this issue?  I am stumped why the only element not working in the audio output is the headphone jack via the EMDR GUI audio test.

Harvey71, 2023-07-03:
Hi deestruct, please try to configure default audio output to jack. One way to do so is via command line:
`sudo amixer cset numid=3 1`

deestruct, 2023-07-04:
I tried the suggested command via SSH and it did not work either.

deestruct, 2023-07-04:
Perhaps I am doing something wrong in testing the audio via headphones.  Below are the steps I am performing to test the headphone jack for audible tones; I performed the steps below today after entering the command line you suggested and rebooting the system.

1) Press the EAR icon to enter the sound menu:
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

2) Try the vertical bar icon and then press the '?' to test the sound:
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

3) Try the circular icon and then press the '?' to test the sound:
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

Harvey71, 2023-07-05:
I found something else in rhe PiBakery recipy that may help:

`echo "dtparam=audio=on"|cat - /boot/config.txt >/boot/config.tmp&&mv /boot/config.tmp /boot/config.txt`

You would have to execute this as root and do a reboot.

deestruct, 2023-07-05:
I didn't initially execute that command as when I checked the config file it already had the following lines active:
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

I did execute the command though and it added the same line at the top of the config file as shown below:
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

After rebooting, it still behaves the same.

Closed 2023-09-02.

Thread 10 (2024-01-04):

EMDR bar and Teensy 4.0

Mllwsummer, 2024-01-04:
Hello Thomas,

I have built your bar and it is wonderful, but now my spouse broke the board... again.

My problem is that the Teensy LC has been discontinued and I ordered the Teensy 4.0.

My other problem is that I'm not smart enough to determine how to wire up the Teensy 4.0 since the Teensy LC had buffer pin specifically for the LEDs.

Could you please provide me some guidance on how to wire up your awesome project using a Teensy 4.0 please?

’Hallo Thomas,

Ich habe deine Bar gebaut, und sie ist wunderbar, aber jetzt hat mein Ehepartner die Platte wieder zerbrochen.

Mein Problem ist, dass der Teensy LC eingestellt wurde, und ich stattdessen den Teensy 4.0 bestellt habe.

Ein weiteres Problem ist, dass ich nicht klug genug bin, um herauszufinden, wie ich den Teensy 4.0 verkabeln soll, da der Teensy LC spezielle Pufferpins für die LEDs hatte.

Könntest du mir bitte Anleitungen geben, wie ich dein tolles Projekt mit einem Teensy 4.0 verkabeln kann?’

Harvey71, 2024-01-25:
Hi, sorry for the late response. But first I had to order the Teensy 4.0 and wait for it to be delivered, than I had to adapt the software, test it, update documentation, etc. And as the Teensy 4.0 is quite expensive, I also wanted to provide cheaper alternatives.
This project is updated now and you will find all necessary information (like wiring) in the readme. You would also have to update your controller software to the latest version. Let me know, if you need further support.

Thread 12 (2024-03-01):

Buzzers microcontroller replacement :)

deestruct, 2024-03-01:
Replacing the Buzzers microcontroller similarly to how you did the Lightbar would be wonderful.  My wife uses it in her practice and her clients typically have opted for the Buzzers rather then the Lightbar, however having both Lightbar and Buzzers available would be great.  Current pricing for Teensy 4.0 units here are priced extremely high.

Harvey71, 2024-03-10:
Hey, I just added new firmware sources and updated the documentation with microcontroller replacements for the buzzers. :-)

deestruct, 2024-03-13:
Thank you!  Your efforts are greatly appreciated.

Closed 2024-03-13.

Thread 13 (2024-06-14):

Issue when pressing the stop button

KaboomFox, 2024-06-14:
When I press the stop button, The buzzer stops. However, light bar slows down but still moves. It then will not allow me to press play again. It is still greyed out. It never recovers.

Harvey71, 2024-06-16:
Could you give me some more information, like
- Do you use the latest controller software version from this repository?
- On what system (Mac, Windows PC, Raspberry Pi) are you running the controller app?
- How many LEDs do you have? Have you set this value both in the controller app (`num_led` devices.py) and light bar firmware (`NUMLED` in lightbar/lightbar.ino or lightbar/main.py)?
- Could you give me the output of `pip freeze`?
- You say, the light bar slows down. That's intentional. But it should stop at the middle of the light bar. Does it do that or will it move forever?
- Could you please take either a screenshot of the stuck application or describe exactly which buttons are greyed out?

KaboomFox, 2024-06-19:
I'm using the latest controller software. I'm using a Raspberry PI 5, 7" raspberry pi touchscreen and two Teensy LCs . I am also using https://www.amazon.com/gp/product/B08XXBSF1P/ref=ppx_yo_dt_b_search_asin_title?ie=UTF8&psc=1 for vibration motors but I don't think that is the issue.

I have 98 LEDs. I changed the number in both files. I have a 7" screen and if I go above a certain screen size, the light bar and vibration pads go out of sync or I get a seg fault. I can avoid this issue by making the screen size slightly smaller than fullscreen.

Once I press stop the light bar slows down and slowly goes to the middle of the bar but it takes 2 minutes to do so. I think the issue is the number of LEDs. I changed the main.py file back to 57 and it worked better. Any suggestions? Trying to avoid remaking the light bar.
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

KaboomFox, 2024-06-19:
Also thank you! This project is amazing.

Harvey71, 2024-06-20:
The reason for the issue was the higher number of LEDs. The speed decay was only tuned and tested for 57 LEDs and way too slow for 98. I changed the calculation and it will now always decay in a way that the delay between the last two LEDs will be 1.5 seconds, exponentially approximated. If you update to the latest version or just cherry-pick commit 4f339f9d6e1e9598fdfcbe8978ded8839cbd7c1d your issue should be fixed.

If you want to change the behaviour, you can edit line 580 of main.py - best change the "1.5" to any amount of seconds you want the last delay to be.

KaboomFox, 2024-06-24:
Related issue:

At higher speeds the vibration pads get out of sync and I get an interesting freezing with the lights. Any ideas?

Uploading IMG_4919.MOV…

Harvey71, 2024-06-29:
This issue should be fixed now, too. Please update all firmware (light bar and buzzers) and controller software.

KaboomFox, 2024-07-12:
Unfortunately, now the light doesn't go across the whole bar. I updated` led_num` in devices.py to`98` and `NUMLED` to `98` in the lightbar.ino file.
https://github.com/user-attachments/assets/c3694390-6b16-40ed-9045-93ea73af7f13

Harvey71, 2024-07-12:
It should work with 100 LEDs though. Before you switch them out, could you please do the following checks?
- Disconnect and reconnect the light bar. Does the left most LED light up green and the right most LED light up red? If not, please double check the INO file and burn the firmware again.
- On the controller start the light bar test mode. You can do so by clicking on the icon with the eye and then click on the icon with the questionmark. Does the left most and right most LED light up? If not, please double check your devices.py file and copy the Python files to the Raspberry Pi again.

Harvey71, 2024-07-12:
BTW: I have ordered a 1 M 100 LED stripe, which will arrive tomorrow. I will test it as soon as I hold it in my hands and come back to you.

Harvey71, 2024-07-13:
OMG. I found the bug. In one place in the lightbar.ino file, there was still a hard coded limit of 60 LEDs. 😳 Fixed with the latest commit. You would only have to update the lightbar firmware. Sorry for the inconvenience.

KaboomFox, 2024-07-14:
You are awesome. Looks like everything is working. I'm going to run some tests and make sure nothing gets out of sync during a 90 min session but looking good so far.

KaboomFox, 2024-08-01:
Closing the ticket. Thank you!

Closed 2024-08-01.

Thread 14 (2025-01-19):

Changing number of LEDs breaks the app

Aaryan-Kapoor, 2025-01-19:
Great project, but slight issue. I have an LED strip with approximately 140 LEDs throughout its length. The app works fine at the hardcoded 57 LEDs but completely breaks when I change it to 140 LEDs. I made the changes specifically in:

In the controller directory:
1. Under devices.py: change led_num to 140 from 57.

In the firmware directory:
1. In lightbar.ino change NUMLED to 140 from 57.
2. In main.py change NUMLED to 140 from 57

I am using a Raspberry Pi Pico
This light strip: https://a.co/d/1lKjcDb

I would appreciate a fix or a guide on how to fix it as this is truly an amazing project!

Aaryan-Kapoor, 2025-01-19:
Specifically the application freezes when I change the speed or click on any other button after playing the LED animation

Aaryan-Kapoor, 2025-01-19:
Update: Slight improvement, I increased the BUFLEN in lightbar.ino to 2048, and the controller application seems to be more responsive this way. This may hint at a bandwidth or RAM limitation.

Aaryan-Kapoor, 2025-01-19:
@Harvey71 Right now, only one LED is ping-ponging back and forth, which requires a high amount of FPS to address each individual LED out of the 140, hence increasing the bandwidth required.

Could we increase the number of LEDs that ping-pong back and forth to 2-3 so that we don't need as much bandwidth? This would reduce the required bandwidth by a lot, making the app way faster.

Aaryan-Kapoor, 2025-01-27:
Update: I was able to circumvent the issue by getting another strip with a lower amount of LEDs per meter. However, I strongly believe that the issue is limited bandwidth. So anyone reading this, try getting a more powerful strip controller instead of the pico if you have a high LEDs/m count.

Thread 15 (2025-02-12):

How to implement ESP32

Aaryan-Kapoor, 2025-02-12:
I tried going through and changing stuff but wasn't able to get it to work with my ESP32.

Harvey71, 2025-02-12:
Hey, @Aaryan-Kapoor.
Could you provide more information? What exactly is not working with ESP32?
Depending on your answer, other pieces of information could be relevant, like:
- How many LEDs has your LED strip?
- Where is your controller software running (Mac, Windows, Linux, Raspberry Pi)?
- When connecting the ESP, does the light bar show the init colors (red and green at the end of the light bar)?
- Can the host system, where the controller runs on, see the USB devices (try lsudb)?
- What did you change in the code apart from the number of LEDs?

Aaryan-Kapoor, 2025-02-12:
@Harvey71 Apologies for the vague message earlier. Here are the details of my setup and the issue I'm facing:

### System & Hardware Details:
- **Operating System**: Windows
- **Microcontroller**: ESP32-WROOM ([Amazon](https://a.co/d/iSzeHEn))
- **LED Strip**: Cut to 57 LEDs ([Amazon](https://a.co/d/4YcItI6))
- **MicroPython Installed**: ESP32 appears under COM6

- 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

### Issue:
- The **initial red/green lights** do not turn on when connecting the ESP32.
- The LED strip itself **works fine** when tested with a Raspberry Pi Pico.
- **ESP32 Setup:**
  - 5V connected to **VIN**
  - GND connected to **GND**
  - Data line connected to **RX2** (I tried different pins but nothing seemed to work)

### Code Modifications:
I've updated the number of LEDs in the following files:
**Controller directory:**
- `devices.py`: Changed `led_num` to **57**

**Firmware directory:**
- `lightbar.ino`: Changed `NUMLED` to **57**
- `main.py`: Changed `NUMLED` to **57**

### Troubleshooting Steps Taken:
- **Tried using a level shifter** in the middle replicating the D1 ESP8266 mini setup in this repo, but the issue persists.
- The same LED strip **worked with [WLED](https://kno.wled.ge/)** without needing a level shifter.

### ESP32 Pin Layout:
```
ROW1: VIN, GND, D13, D12, D14, D27, D26, D25, D33, D32, D35, D34, UN, UP, EN
ROW2: 3V3, GND, D15, D2, D4, RX2, TX2, D5, D18, D19, D21, RX0, TX0, D22, D23
```

### Suspected Issues:
1. **Incorrect pin connections**
2. **Project may not support ESP32** (ESP32 is not listed in `controller/devices_config.py`)

Let me know if you need any additional details! I would really appreciate your help!

Aaryan-Kapoor, 2025-02-19:
Hey @Harvey71,

I would really appreciate your help with this project and am looking forward to hearing from you soon!

Harvey71, 2025-02-21:
Sorry, Aayan. Actually, the ESP32-Wroom was not supported by this project.
But I ordered one to try it out. I just committed a change in the firmware code to support your microcontroller.

Please follow the D1-Mini instructions, **except**:
- Connect the data line to **D4** on the ESP developer board.
- I recommend using a level shifter and have not tested without it, but if it works for you, just go for it.
- At "Configure Interpreter" use "**MyrcoPython (ESP32)**" as interpreter, "**ESP32**" as family, "**Espressif - ESP32 / WROOM**" as variant and "**1.24.1**" as version.
- Update your git repo, adjust your LED num and copy "main.py" and "neopixel.py" to your microcontroller
- After reboot, your outer LED should light up in red and green for a second.

Please let me know whether this solves your issue.

Aaryan-Kapoor, 2025-02-22:
Hey @Harvey71, thank you so much for the response!

So progress is that the initialization lights now light up but the controller software is not able to detect the ESP32. Thonny detects it and I am able to upload new code.

I tested both with and without the level shifter, but still had the same behavior.

Harvey71, 2025-02-22:
That the initialization lights work is a good sign. But I forgot to adjust the controller software. I I have just made up for it. Please pull and replace the controller source code (at least the file "device_setup.py").
