Harvey71/emdr/(commit log)

2020-01-16 pictographic buttons
2020-01-17 detach drive from kernel if nescessary (need to be for raspberry pi)
2020-01-17 change pause behaviour, flip +/- btns and fullscreen/touchscreen flags
    [main.py]
2020-01-20 add PiBakery recipe for raspberry pi
2020-01-20 add photos of devices
2020-09-24 change to high performance timer for higher frequency, especially under Windows
2022-02-02 fix typos and translate UI to English
    [lightbar.ino]
2022-03-12 clarify teensy/led strip wiring
2022-09-03 fixes for Raspberry Pi
2024-01-25 Support different microcontroller boards as replacements for Teensy LC (lightbar only)
    [lightbar.ino, main.py, neopixel.py]
2024-03-10 Now also for buzzers: support different microcontroller boards as replacements for Teensy LC
    [main.py]
2024-06-20 Fix speed decay for all numbers of LED (used to be too slow with high numbers)
    [main.py]
2024-06-29 Make buzzer interruptable (Teensy only)
    [buzzer.ino]
2024-06-29 Increase Teensy LC baud rate to 115200
2024-06-29 Fix Teensy compile time detection
    [lightbar.ino]
2024-07-13 Fix lightbar for more than 60 LEDs
    [lightbar.ino]
2025-02-21 Support for ESP32-Wroom (Lightbar)
2025-02-22 Support for ESP32-Wroom (Controller)
